brainboxemb/exp.2026-005.scad-detachable-clip-interface/dsg/drawing/opengrid_lite_plan_slice_reference.scad

// Independent OpenSCAD horizontal-section oracle for the Python top view.
//
// Python derives every contour independently. This file only cuts the actual
// pinned OpenGrid Lite 3D model at a requested Lite-local Z height.
//
// openGridLite() is centred on Z=0 and is 4.0 mm high, so Lite-local Z 0..4
// maps to model Z -2..+2. projection(cut=true) on the exact upper boundary
// produces no 2D object in OpenSCAD, so only that oracle cut is moved 0.00001
// mm into the solid. Python still evaluates the mathematical Z=4.0 profile.

include <../openscad/lib/opengrid_reference.scad>

slice_z_mm = is_undef(slice_z_mm) ? 1.6 : slice_z_mm;
top_cut_epsilon_mm = 0.00001;

assert(slice_z_mm >= 0.0);
assert(slice_z_mm <= 4.0);

effective_slice_z_mm =
    slice_z_mm == 4.0
    ? 4.0 - top_cut_epsilon_mm
    : slice_z_mm;

projection(cut = true)
    translate([0, 0, 2.0 - effective_slice_z_mm])
        opengrid_lite_receiver();
