brainboxemb/exp.2026-005.scad-detachable-clip-interface/dsg/openscad/export/01-opengrid-lite-receiver.scad

include <../lib/opengrid_reference.scad>

opengrid_lite_receiver();
