brainboxemb/exp.2026-005.scad-detachable-clip-interface/dsg/openscad/export/02-opengrid-lite-snap.scad

include <../lib/opengrid_reference.scad>

opengrid_lite_snap();
