brainboxemb/exp.2026-005.scad-detachable-clip-interface/dsg/openscad/export/03-node-receiver.scad

include <BOSL2/std.scad>

$fn = 120;
use <../components/node-receiver/node_receiver.scad>

node_receiver_build(false);
