brainboxemb/exp.2026-005.scad-detachable-clip-interface/dsg/openscad/export/04-node-snap.scad

include <BOSL2/std.scad>

$fn = 120;
use <../components/node-snap/node_snap.scad>

node_snap_build(true);
