brainboxemb/exp.2026-005.scad-detachable-clip-interface/dsg/openscad/export/30-node-rail-retention-profile.scad

include <../lib/node_interface.scad>
node_receiver_retention_profile(0);
