brainboxemb/exp.2026-005.scad-detachable-clip-interface/dsg/openscad/export/31-node-plate-retention-profile.scad

include <../lib/node_interface.scad>
node_receiver_retention_profile(1);
