brainboxemb/exp.2026-005.scad-detachable-clip-interface/dsg/openscad/export/32-node-rail-transition-profile.scad

include <../lib/node_interface.scad>
node_receiver_transition_profile(0);
