brainboxemb/exp.2026-005.scad-detachable-clip-interface/dsg/openscad/export/33-node-plate-transition-profile.scad

include <../lib/node_interface.scad>
node_receiver_transition_profile(1);
