brainboxemb/exp.2026-005.scad-detachable-clip-interface/dsg/openscad/export/34-node-snap-retention-profile.scad

include <../lib/node_interface.scad>
node_snap_retention_profile();
