brainboxemb/exp.2026-005.scad-detachable-clip-interface/dsg/openscad/export/40-opengrid-lite-receiver-flex-profile.scad

include <../lib/opengrid_reference.scad>

opengrid_lite_receiver_profile();
