brainboxemb/exp.2026-005.scad-detachable-clip-interface/dsg/openscad/export/41-opengrid-lite-snap-flex-profile.scad

include <../lib/opengrid_reference.scad>

opengrid_lite_snap_profile();
