brainboxemb/exp.2026-005.scad-detachable-clip-interface/dsg/openscad/export/42-opengrid-lite-receiver-solid-profile.scad

include <../lib/opengrid_reference.scad>
opengrid_lite_receiver_solid_profile();
