brainboxemb/exp.2026-005.scad-detachable-clip-interface/dsg/openscad/export/43-opengrid-lite-snap-solid-profile.scad

include <../lib/opengrid_reference.scad>
opengrid_lite_snap_solid_profile();
