brainboxemb/exp.2026-005.scad-detachable-clip-interface/dsg/openscad/export/50-reference-full-receiver.scad

// OpenGrid Full fixed upstream OpenGrid receiver STL.

include <../lib/opengrid_reference.scad>

opengrid_full_receiver();
