brainboxemb/exp.2026-005.scad-detachable-clip-interface/dsg/openscad/export/51-reference-full-snap.scad

// OpenGrid Full removable upstream OpenGrid snap STL.

include <../lib/opengrid_reference.scad>

opengrid_full_snap();
