brainboxemb/exp.2026-005.scad-detachable-clip-interface/dsg/openscad/export/60-reference-full-receiver-flex-profile.scad

include <../lib/opengrid_reference.scad>

opengrid_full_receiver_profile();
