brainboxemb/exp.2026-005.scad-detachable-clip-interface/dsg/openscad/export/61-reference-full-snap-flex-profile.scad

include <../lib/opengrid_reference.scad>

opengrid_full_snap_profile();
