brainboxemb/exp.2026-005.scad-detachable-clip-interface/dsg/openscad/export/62-reference-full-receiver-solid-profile.scad

include <../lib/opengrid_reference.scad>
opengrid_full_receiver_solid_profile();
