brainboxemb/exp.2026-005.scad-detachable-clip-interface/dsg/openscad/export/63-reference-full-snap-solid-profile.scad

include <../lib/opengrid_reference.scad>
opengrid_full_snap_solid_profile();
