brainboxemb/exp.2026-005.scad-detachable-clip-interface/dsg/openscad/render/07-node-snap-retention-profile.scad

include <../lib/node_interface.scad>
$vpt=[0,0,2.3]; $vpr=[90,0,0]; $vpd=44;
color([0.92,0.30,0.12]) node_snap_retention_profile();
