brainboxemb/exp.2026-005.scad-detachable-clip-interface/dsg/openscad/render/20-node-rail-exploded.scad

include <../lib/node_interface.scad>
$vpt=[0,0,6]; $vpr=[68,0,28]; $vpd=130;
node_example_exploded(0, mm_pattern=true);
