brainboxemb/exp.2026-005.scad-detachable-clip-interface/dsg/openscad/render/21-node-plate-exploded.scad

include <../lib/node_interface.scad>
$vpt=[0,0,12]; $vpr=[68,0,28]; $vpd=135;
node_example_exploded(1, mm_pattern=true);
