brainboxemb/exp.2026-005.scad-detachable-clip-interface/dsg/openscad/render/30-node-rail-retention-section.scad

include <../lib/node_interface.scad>
$vpt=[0,0,2]; $vpr=[90,0,0]; $vpd=48;
node_retention_section(0);
