brainboxemb/exp.2026-005.scad-detachable-clip-interface/dsg/openscad/render/31-node-plate-retention-section.scad

include <../lib/node_interface.scad>
$vpt=[0,0,8]; $vpr=[90,0,0]; $vpd=62;
node_retention_section(1);
