brainboxemb/exp.2026-005.scad-detachable-clip-interface/dsg/openscad/render/32-node-rail-transition-section.scad

include <../lib/node_interface.scad>
$vpt=[0,0,EVIDENCE_TRANSITION_PLAN_Z]; $vpr=[0,0,0]; $vpd=105;
node_transition_section(0);
