brainboxemb/exp.2026-005.scad-detachable-clip-interface/dsg/openscad/render/33-node-plate-transition-section.scad

include <../lib/node_interface.scad>
$vpt=[0,0,EXAMPLE_PLATE_HEIGHT + EVIDENCE_TRANSITION_PLAN_Z]; $vpr=[0,0,0]; $vpd=105;
node_transition_section(1);
