brainboxemb/exp.2026-005.scad-detachable-clip-interface/dsg/openscad/render/42-opengrid-lite-receiver-flex-profile.scad

include <../lib/opengrid_reference.scad>

$vpt = [0, 0, 2.0];
$vpr = [90, 0, 0];
$vpd = 70;

color([0.70, 0.72, 0.76])
    opengrid_lite_receiver_profile();
