brainboxemb/exp.2026-005.scad-detachable-clip-interface/dsg/openscad/render/43-opengrid-lite-snap-flex-profile.scad

include <../lib/opengrid_reference.scad>

$vpt = [0, 0, 1.7];
$vpr = [90, 0, 0];
$vpd = 66;

color([0.90, 0.28, 0.14])
    opengrid_lite_snap_profile();
