brainboxemb/exp.2026-005.scad-detachable-clip-interface/dsg/openscad/render/50-reference-full-baseline-assembled.scad

// OpenGrid Full assembled upstream reference.

include <../lib/opengrid_reference.scad>

$vpt = [0, 0, 4];
$vpr = [65, 0, 35];
$vpd = 90;

opengrid_full_assembled();
