brainboxemb/exp.2026-005.scad-detachable-clip-interface/dsg/openscad/render/51-reference-full-baseline-exploded.scad

// OpenGrid Full exploded upstream reference.

include <../lib/opengrid_reference.scad>

$vpt = [0, 0, 8];
$vpr = [65, 0, 35];
$vpd = 105;

opengrid_full_exploded();
