brainboxemb/exp.2026-005.scad-detachable-clip-interface/dsg/openscad/render/52-reference-full-baseline-section.scad

// OpenGrid Full cutaway showing receiver/snap mating geometry.

include <../lib/opengrid_reference.scad>

$vpt = [0, -2, 3.4];
$vpr = [78, 0, 25];
$vpd = 78;

opengrid_full_half_section();
