brainboxemb/exp.2026-005.scad-detachable-clip-interface/dsg/openscad/render/55-reference-full-receiver-flex-profile.scad

include <../lib/opengrid_reference.scad>

$vpt = [0, 0, 3.4];
$vpr = [90, 0, 0];
$vpd = 70;

color([0.70, 0.72, 0.76])
    opengrid_full_receiver_profile();
