brainboxemb/exp.2026-005.scad-detachable-clip-interface/dsg/openscad/render/60-reference-full-vs-lite-assembled.scad

include <../lib/opengrid_reference.scad>

$vpt = [0, 0, 3.4];
$vpr = [68, 0, 28];
$vpd = 122;

opengrid_comparison_assembled();
