brainboxemb/exp.2026-005.scad-detachable-clip-interface/dsg/openscad/render/61-reference-full-vs-lite-exploded.scad

include <../lib/opengrid_reference.scad>

$vpt = [0, 0, 9];
$vpr = [68, 0, 28];
$vpd = 142;

opengrid_comparison_exploded();
