brainboxemb/exp.2026-005.scad-detachable-clip-interface/dsg/openscad/render/62-reference-full-vs-lite-section.scad

include <../lib/opengrid_reference.scad>

$vpt = [0, 0, 3.4];
$vpr = [82, 0, 18];
$vpd = 110;

opengrid_comparison_section();
