brainboxemb/exp.2026-005.scad-detachable-clip-interface/dsg/openscad/render/63-reference-full-vs-lite-flex-section.scad

include <../lib/opengrid_reference.scad>

$vpt = [0, 0, 3.4];
$vpr = [82, 0, 18];
$vpd = 110;

opengrid_comparison_flex_section();
