brainboxemb/exp.2026-005.scad-detachable-clip-interface/dsg/openscad/render2d/00-opengrid-local-mating-profile.scad

// SPDX-License-Identifier: CC-BY-NC-SA-4.0
use <../specification/mating_profiles.scad>
opengrid_mating_profile_sheet();
