brainboxemb/exp.2026-005.scad-detachable-clip-interface/dsg/openscad/render2d/01-node-fixed-tongue-profile-a4.scad

// SPDX-License-Identifier: CC-BY-NC-SA-4.0
use <../specification/mating_profiles.scad>
node_profile_a4();
