brainboxemb/exp.2026-005.scad-detachable-clip-interface/dsg/openscad/render2d/02-node-snap-profile.scad

// SPDX-License-Identifier: CC-BY-NC-SA-4.0
// Standalone 2D snap drawing entrypoint.

use <../components/node-snap/node_snap/node_snap_drawing.scad>

node_snap_profile_drawing();
