brainboxemb/exp.2026-005.scad-detachable-clip-interface/dsg/openscad/render2d/12-reference-implementation.scad

// SPDX-License-Identifier: CC-BY-NC-SA-4.0
use <../specification/interface_specification.scad>
reference_implementation_sheet();
