brainboxemb/exp.2026-005.scad-detachable-clip-interface/dsg/openscad/render2d/20-node-receiver-detail.scad

// SPDX-License-Identifier: CC-BY-NC-SA-4.0
use <../components/node-receiver/node_receiver/node_receiver_drawing.scad>
node_receiver_profile_drawing();
