brainboxemb/exp.2026-005.scad-detachable-clip-interface/(list of files, cad)

Other CAD files:
dsg/openscad/render/02-opengrid-lite-snap.scad
dsg/openscad/render/34-node-snap-retention-profile.scad
dsg/openscad/render/41-opengrid-lite-flex-section.scad
dsg/openscad/render/44-opengrid-lite-receiver-solid-profile.scad
dsg/openscad/render/45-opengrid-lite-snap-solid-profile.scad
dsg/openscad/render/53-reference-full-section.scad
dsg/openscad/render/54-reference-full-flex-section.scad
dsg/openscad/render/56-reference-full-snap-flex-profile.scad
dsg/openscad/render/57-reference-full-receiver-solid-profile.scad
dsg/openscad/render/58-reference-full-snap-solid-profile.scad
dsg/openscad/render2d/21-node-snap-detail.scad
dsg/openscad/components/node-receiver/node_receiver/node_receiver_render.scad
dsg/openscad/components/node-snap/node_snap/node_snap_drawing.scad
dsg/openscad/components/node-snap/node_snap/node_snap_render.scad
dsg/openscad/components/opengrid-lite-receiver/opengrid_lite_receiver/opengrid_lite_receiver_render.scad
dsg/openscad/components/opengrid-lite-snap/opengrid_lite_snap/opengrid_lite_snap_render.scad
dsg/openscad/examples/receiver-plate/receiver_plate_assembled_example.scad
dsg/openscad/examples/receiver-plate/receiver_plate_example.scad
dsg/openscad/examples/receiver-rail/receiver_rail_assembled_example.scad
dsg/openscad/examples/receiver-rail/receiver_rail_example.scad
dsg/openscad/export/10-example-receiver-rail.scad
dsg/openscad/export/11-example-receiver-plate.scad
dsg/openscad/render/10-example-receiver-rail.scad
dsg/openscad/render/11-example-receiver-plate.scad
dsg/openscad/render/12-example-rail-assembled.scad
dsg/openscad/render/13-example-plate-assembled.scad
