brainboxemb/exp.2026-005.scad-detachable-clip-interface/(commit log)

2026-09-18 experiment: bootstrap OG-01 OpenGrid reference
    [main.scad, og-01-fixed-receiver.scad, og-01-reference-assembled.scad, og-01-reference-exploded.scad, og-01-reference-section.scad, og-01-removable-snap.scad]
2026-09-18 fix: initialize BOSL2 in OG-01 entrypoint
    [main.scad]
2026-09-18 experiment: compare OpenGrid Full and Lite profiles
    [og-02-full-lite-assembled.scad, og-02-full-lite-exploded.scad, og-02-full-lite-section.scad, og-02-lite-receiver.scad, og-02-lite-snap.scad, og-02-profile-full-receiver.scad, og-02-profile-full-snap.scad, og-02-profile-lite-receiver.scad]
2026-09-18 feat: expose experiment views in Customizer
    [main.scad]
2026-09-18 fix: expose solid OpenGrid cross-sections
    [main.scad, og-02-profile-solid-full-receiver.scad, og-02-profile-solid-full-snap.scad, og-02-profile-solid-lite-receiver.scad, og-02-profile-solid-lite-snap.scad]
2026-09-18 experiment: reduce receiver and snap interface
    Retain the current digital receiver/snap design checkpoint with descriptive experiment naming. Physical fit, flex survival and tolerance qualification continue separately.
    [01-opengrid-lite-receiver.scad, 02-opengrid-lite-snap.scad, 03-node-receiver.scad, 04-node-snap.scad, 10-example-receiver-rail.scad, 11-example-receiver-plate.scad, 12-example-rail-assembled.scad, 13-example-plate-assembled.scad]
2026-09-18 fix: keep receiver guidance inside compact footprint
2026-09-18 docs: expose intermediate OpenGrid construction steps
    [opengrid_lite_receiver.scad, opengrid_lite_receiver_render.scad, opengrid_lite_snap.scad, opengrid_lite_snap_render.scad]
2026-09-18 render: tighten receiver evidence framing
    [03-node-receiver.scad, 23-node-receiver-top-comparison.scad, 24-node-rail-vs-plate.scad, node_receiver.scad]
2026-09-18 docs: make design transitions visibly verifiable
    [opengrid_lite_receiver.scad, opengrid_lite_receiver_render.scad, opengrid_lite_snap.scad, opengrid_lite_snap_render.scad]
2026-09-18 fix: keep design render helpers in public scope
    [node_snap.scad, node_snap_render.scad, opengrid_lite_snap_render.scad]
2026-09-18 fix: simplify receiver top insertion guide
    [node_receiver.scad, node_receiver_render.scad]
2026-09-18 docs: make receiver cuts and control views explicit
    [05-node-receiver-top.scad, 06-node-receiver-side.scad, 07-node-snap-retention-profile.scad, node_receiver.scad, node_receiver_render.scad]
2026-09-18 fix: taper receiver guide depth at open ends
    [node_receiver.scad]
2026-09-19 docs: expose source-derived receiver profile
    [node_receiver.scad, node_receiver_render.scad]
2026-09-19 ux: expose design views in OpenSCAD Customizer
    [node_receiver_render.scad, node_snap_render.scad, opengrid_lite_receiver_render.scad, opengrid_lite_snap_render.scad]
2026-09-19 refactor: group SCAD design support one level deeper
    [node_receiver_render.scad, node_snap_render.scad, opengrid_lite_receiver_render.scad, opengrid_lite_snap_render.scad]
2026-09-19 fix: derive receiver as straight OpenGrid profile extrusion
    [node_receiver.scad, node_receiver_render.scad]
2026-09-19 refine: keep receiver functional baseline plain
    [03-node-receiver.scad, 05-node-receiver-top.scad, 06-node-receiver-side.scad, node_receiver.scad]
2026-09-19 docs: add dimensioned SVG profiles with shared render formats
    Pin tool.scad-project v0.14.13, split normal render discovery into 3D/2D roots, and add receiver/snap SVG drawings generated from production geometry through openscad-new-dimensions.
    [01-node-receiver-profile.scad, 02-node-snap-profile.scad, node_receiver_drawing.scad, node_snap_drawing.scad]
2026-09-19 fix: initialize BOSL2 context for SVG drawings
    The design adapter imports drawing modules through use<>, so provide the same BOSL2 special-variable context used by existing design renders before evaluating production geometry.
    [node_receiver_drawing.scad, node_snap_drawing.scad]
2026-09-19 design: split interface specification from reference implementation
    Add a stage-1 10x4 mm mating contract, make the node receiver/snap consume that contract as the minimal stage-2 reference implementation, add specification-first technical drawings, improve SVG sheet readability, and pin tool.scad-project v0.14.14.
    [00-interface-contract.scad, 01-opengrid-to-interface-translation.scad, 02-node-receiver-detail.scad, 03-node-snap-detail.scad, interface_specification.scad, node_receiver_drawing.scad, node_snap_drawing.scad]
2026-09-19 fix: provide BOSL2 context for specification sheets
    All public SVG sheet modules now initialize the BOSL2 special-variable context, including standalone render2d entrypoints that bypass the design-document wrapper.
    [interface_specification.scad]
2026-09-19 spec: define one-side OpenGrid and node mating profiles
    Replace the whole-section-first view with technical profile sheets for one local mating side. Dimension the pinned OpenGrid Lite wall/nub construction, show the node tongue/groove inversion, and demote the symmetric 10 mm section to reference-pair context.
    [00-opengrid-local-mating-profile.scad, 01-node-local-mating-profile.scad, 10-reference-pair-section.scad, 11-width-reduction-context.scad, 12-reference-implementation.scad, 20-node-receiver-detail.scad, 21-node-snap-detail.scad, interface_specification.scad]
2026-09-19 spec: restore longitudinal tongue definition and A4 profiles
    Treat the interface as a 3D mating patch instead of one extruded profile. Restore the compact 10 mm node tongue with an 8 mm active region and 1 mm smooth depth blends, and add A4 OpenGrid/node drawings with both plan and A-A section views.
    [00-opengrid-fixed-profile-a4.scad, 01-node-fixed-tongue-profile-a4.scad, mating_profiles.scad]
2026-09-19 drawing: keep A4 profile views inside the sheet
    Correct the node plan dimension orientation and give both A-A sections proper A4 margins instead of letting dimension geometry expand the SVG canvas.
    [mating_profiles.scad]
2026-09-19 drawing: expose the longitudinal tongue shape at Z 0.8
    Move the plan slices into the lower constant-width band so the OpenGrid edge path and the node 1 mm tongue blends are visually obvious instead of almost disappearing in the shallow top chamfer.
    [mating_profiles.scad]
2026-09-19 build: pin specification-first SCons index support
    Advance tool.scad-project to released v0.14.15 so the experiment's SCons-generated documentation index presents specification documents before component design documents.
2026-09-19 docs: make the longitudinal tongue part of the contract
    Remove the obsolete straight-extrusion narrative, document the 10/8/1/1 longitudinal geometry as part of the stage-1 mating patch, and keep the receiver document focused on its stage-2 implementation.
2026-09-19 drawings: make OpenGrid profile sheet informative
    [mating_profiles.scad]
2026-09-19 drawings: use oriented OpenGrid object overview
    [mating_profiles.scad]
2026-09-19 fix: restore straight receiver profile authority
    Restore the agreed OpenGrid-derived X/Z receiver profile as one unchanged straight 10 mm extrusion, remove the reintroduced 8+1+1 smooth end-blend contract, align drawings/docs, and add an explicit AGENTS no-invention guardrail for authoritative geometry.
    [mating_profiles.scad]
2026-09-19 docs: reopen receiver longitudinal termination
    Stop treating path_extrude2d as node design authority. Record that the pinned OpenGrid receiver combines straight-edge extrusion with separate corner geometry, retain only the established X/Z mating profile as normative, and mark the node Y termination/current STL as an implementation candidate under review.
    [mating_profiles.scad]
2026-09-19 drawings: add drawsvg OpenGrid profile sheet
    [opengrid_fixed_profile_sources.scad]
2026-09-19 drawings: initialize BOSL2 source-view context
    [opengrid_fixed_profile_sources.scad]
2026-09-19 drawings: make composed OpenGrid sheet canonical
    [00-opengrid-fixed-profile-a4.scad]
2026-09-19 drawings: reduce OpenGrid work to one outline test
    [opengrid_fixed_profile_sources.scad]
2026-09-19 feat: add interactive section inspection
    [main.scad]
2026-09-19 fix: retain requested section depth
    [main.scad]
2026-09-19 fix: make section depth an exact retained slice
    [main.scad]
2026-09-19 refactor: use shared SCAD section utility
    [main.scad]
2026-09-19 chore: sync shared section inspection dependency
    [main.scad]
2026-09-19 chore: pin merged SCAD utility library
2026-09-19 feat: reconstruct OpenGrid plan geometry in millimetres
    [opengrid_lite_plan_reference.scad]
2026-09-19 drawing: merge source-derived OpenGrid height contours
    [opengrid_lite_plan_reference.scad, opengrid_lite_plan_slice_reference.scad]
2026-09-19 refactor: separate OpenGrid geometry from SVG rendering
    [opengrid_lite_plan_slice_reference.scad]
